UCSBRoboticsClub/viacar-2014/Solidworks/VC01.SLDPRT

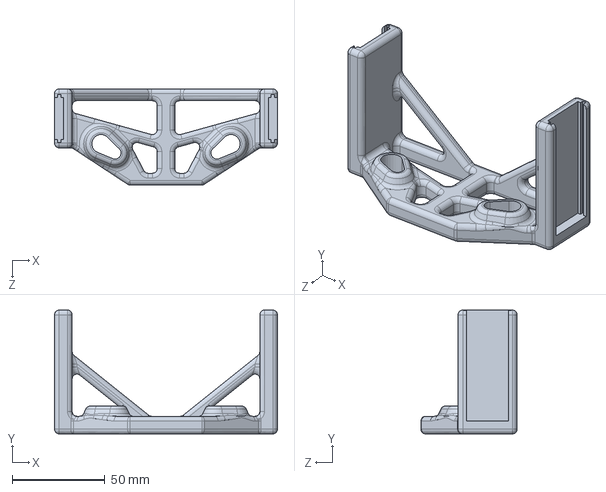
[picture p1: CAD file, 2014-02-02]
Solidworks/VC01.SLDPRT
120.0 x 66.7 x 51.8 mm
