UCSBRoboticsClub/viacar-2014/Solidworks/VC02.SLDPRT

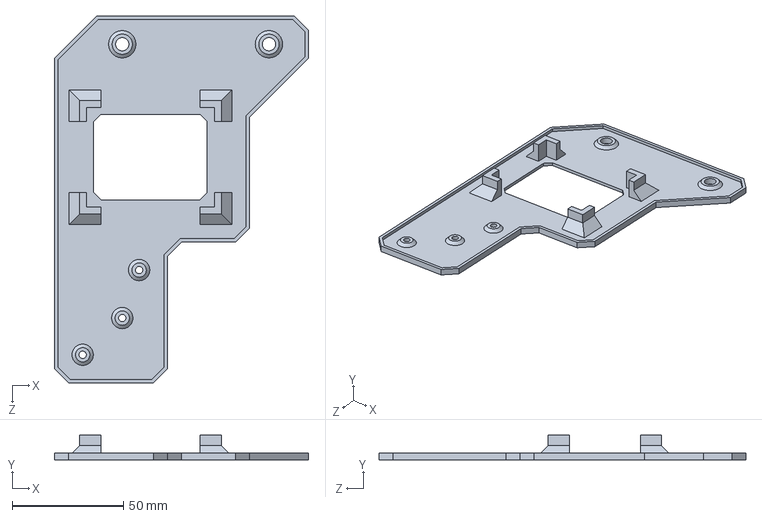
[picture p2: CAD file, 2014-01-17]
Solidworks/VC02.SLDPRT
114.3 x 11.1 x 165.1 mm
