UCSBRoboticsClub/viacar-2014/(list of files, cad)

Other CAD files:
Solidworks/VC01.STL
Solidworks/VC02.SLDDRW
