UCSBRoboticsClub/viacar-2014/Board files/sensor.brd

## EAGLE design Board files/sensor.brd (2014-03-01)

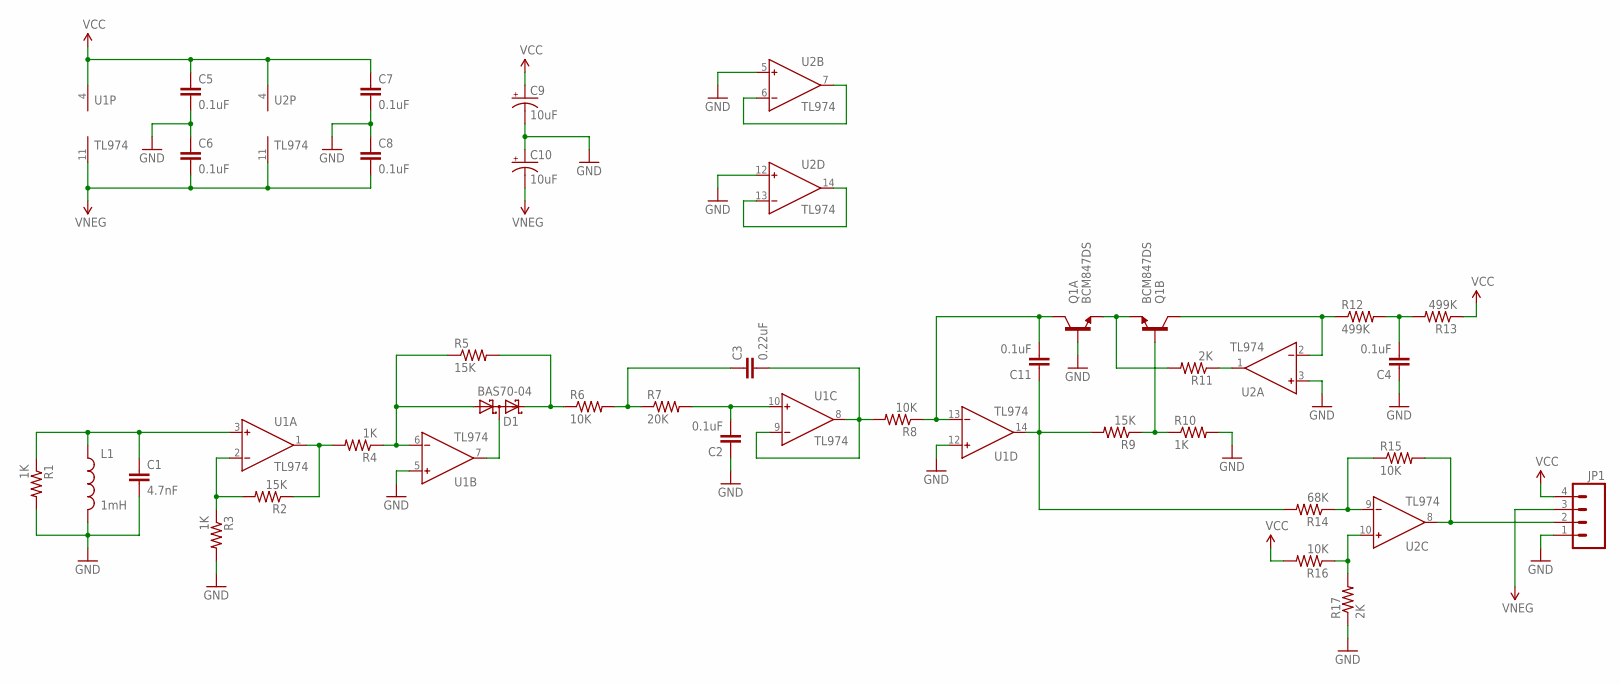
[picture p3: schematic sensor.sch]

Parts:
C1: 4.7nF; 0805
C2, C4, C5, C6, C7, C8, C11: 0.1uF; 0805
C3: 0.22uF; 0805
C9, C10: 10uF; E2-4
D1: BAS70-04; SOT23
JP1: M04POLAR_LOCK; MOLEX-1X4_LOCK
L1: 1mH; RLB0912
Q1: BCM847DS; SOT-457
R1, R3, R4, R10: 1K; 0805
R2, R5, R9: 15K; 0805
R6, R8, R15, R16: 10K; 0805
R7: 20K; 0805
R11, R17: 2K; 0805
R12, R13: 499K; 0805
R14: 68K; 0805
U1, U2: TL974; SOIC-14

Connections:
GND: C1.2, C2.1, C4.1, C5.2, C6.1, C7.2, C8.1, C9.-, C10.+, JP1.1, L1.2, Q1.2 (B), R1.2, R3.2, R10.2, R17.1, U1.5 (IN+), U1.12 (IN+), U2.3 (IN+), U2.5 (IN+), U2.12 (IN+)
unnamed: C1.1, L1.1, R1.1, U1.3 (IN+)
unnamed: D1.1 (A1), R4.1, R5.1, U1.6 (IN-)
unnamed: R2.2, R3.1, U1.2 (IN-)
unnamed: R2.1, R4.2, U1.1 (OUT)
unnamed: D1.2 (C2), R5.2, R6.1
unnamed: C2.2, R7.2, U1.10 (IN+)
unnamed: C3.1, R6.2, R7.1
unnamed: D1.3 (C1A2), U1.7 (OUT)
unnamed: U2.6 (IN-), U2.7 (OUT)
unnamed: C3.2, R8.2, U1.8 (OUT), U1.9 (IN-)
unnamed: U2.13 (IN-), U2.14 (OUT)
unnamed: C11.2, Q1.6 (C), R8.1, U1.13 (IN-)
unnamed: R11.1, U2.1 (OUT)
unnamed: Q1.1 (E), Q1.4 (E), R11.2
unnamed: Q1.5 (B), R9.1, R10.1
unnamed: C11.1, R9.2, R14.2, U1.14 (OUT)
unnamed: C4.2, R12.2, R13.2
unnamed: Q1.3 (C), R12.1, U2.2 (IN-)
unnamed: R16.1, R17.2, U2.10 (IN+)
unnamed: R14.1, R15.1, U2.9 (IN-)
unnamed: JP1.2, R15.2, U2.8 (OUT)
VCC: C5.1, C7.1, C9.+, JP1.4, R13.1, R16.2, U1.4 (V+), U2.4 (V+)
VNEG: C6.2, C8.2, C10.-, JP1.3, U1.11 (V-), U2.11 (V-)

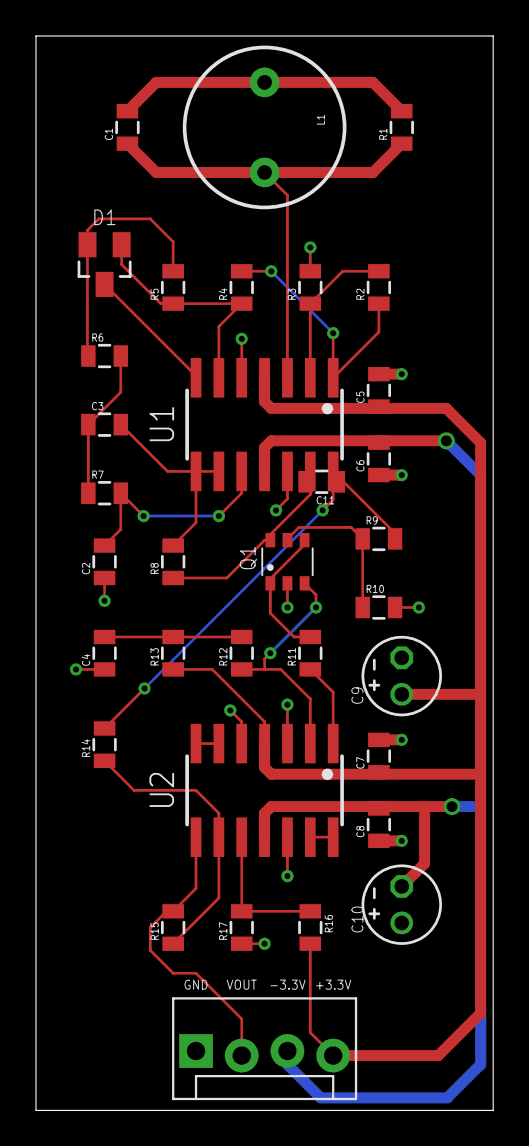
[picture p4: board sensor.brd from above]

Board: 2 copper layers, 25.4 x 59.7 mm, 34 parts (0 on the bottom side), 24 nets.
