UCSBRoboticsClub/viacar-2014/Board files/logic.brd

## EAGLE design Board files/logic.brd (2014-01-12)

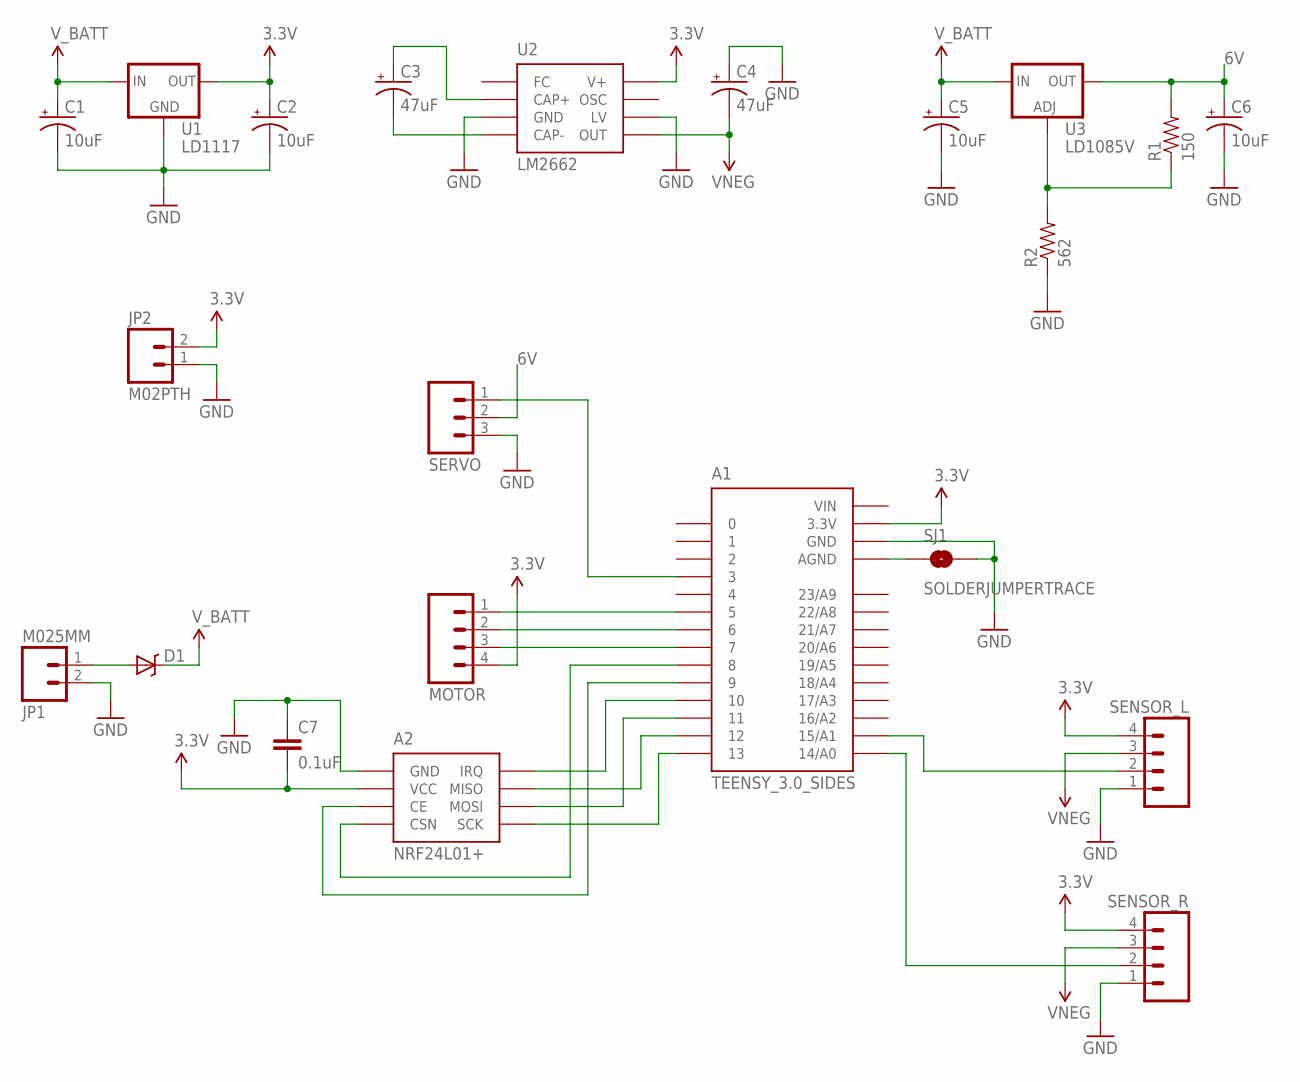
[picture p5: schematic logic.sch]

Parts:
A1: TEENSY_3.0_SIDES
A2: NRF24L01+
C1, C2, C5, C6: 10uF; E2-4
C3, C4: 47uF; CPOL-RADIAL-100UF-25V
C7: 0.1uF; 0805
D1: DIODE-SCHOTTKY_; SMA-DIODE
JP1: M025MM; SCREWTERMINAL-5MM-2
JP2: M02PTH; 1X02
MOTOR: M04POLAR_LOCK; MOLEX-1X4_LOCK
R1: 150; 0805
R2: 562; 0805
SENSOR_L: M04POLAR_LOCK; MOLEX-1X4_LOCK
SENSOR_R: M04POLAR_LOCK; MOLEX-1X4_LOCK
SERVO: M03LOCK_LONGPADS; 1X03_LOCK_LONGPADS
SJ1: SOLDERJUMPERTRACE; SJ_2S-TRACE
U1: LD1117; SOT-223
U2: LM2662; SOIC-8
U3: LD1085V; 317TS

Connections:
3.3V: A1.3.3V, A2.2 (VCC), C2.+, C7.2, JP2.2, MOTOR.4, SENSOR_L.4, SENSOR_R.4, U1.2 (OUT), U1.4 (OUT), U2.8 (V+)
6V: C6.+, R1.2, SERVO.2, U3.2 (OUT)
GND: A1.GND, A2.1 (GND), C1.-, C2.-, C4.1 (+), C5.-, C6.-, C7.1, JP1.2, JP2.1, R2.1, SENSOR_L.1, SENSOR_R.1, SERVO.3, SJ1.2, U1.1 (GND), U2.3 (GND), U2.6 (LV)
unnamed: D1.A, JP1.1
unnamed: C3.1 (+), U2.2 (CAP+)
unnamed: C3.2 (-), U2.4 (CAP-)
unnamed: R1.1, R2.2, U3.1 (ADJ)
unnamed: A1.13, A2.5 (SCK)
unnamed: A1.12, A2.7 (MISO)
unnamed: A1.11, A2.6 (MOSI)
unnamed: A1.8, A2.4 (CSN)
unnamed: A1.10, A2.8 (IRQ)
unnamed: A1.9, A2.3 (CE)
unnamed: A1.3, SERVO.1
unnamed: A1.AGND, SJ1.1
unnamed: A1.15/A1, SENSOR_L.2
unnamed: A1.14/A0, SENSOR_R.2
unnamed: A1.5, MOTOR.1
unnamed: A1.6, MOTOR.2
unnamed: A1.7, MOTOR.3
VIN: A1.VIN
VNEG: C4.2 (-), SENSOR_L.3, SENSOR_R.3, U2.5 (OUT)
V_BATT: C1.+, C5.+, D1.C, U1.3 (IN), U3.3 (IN)

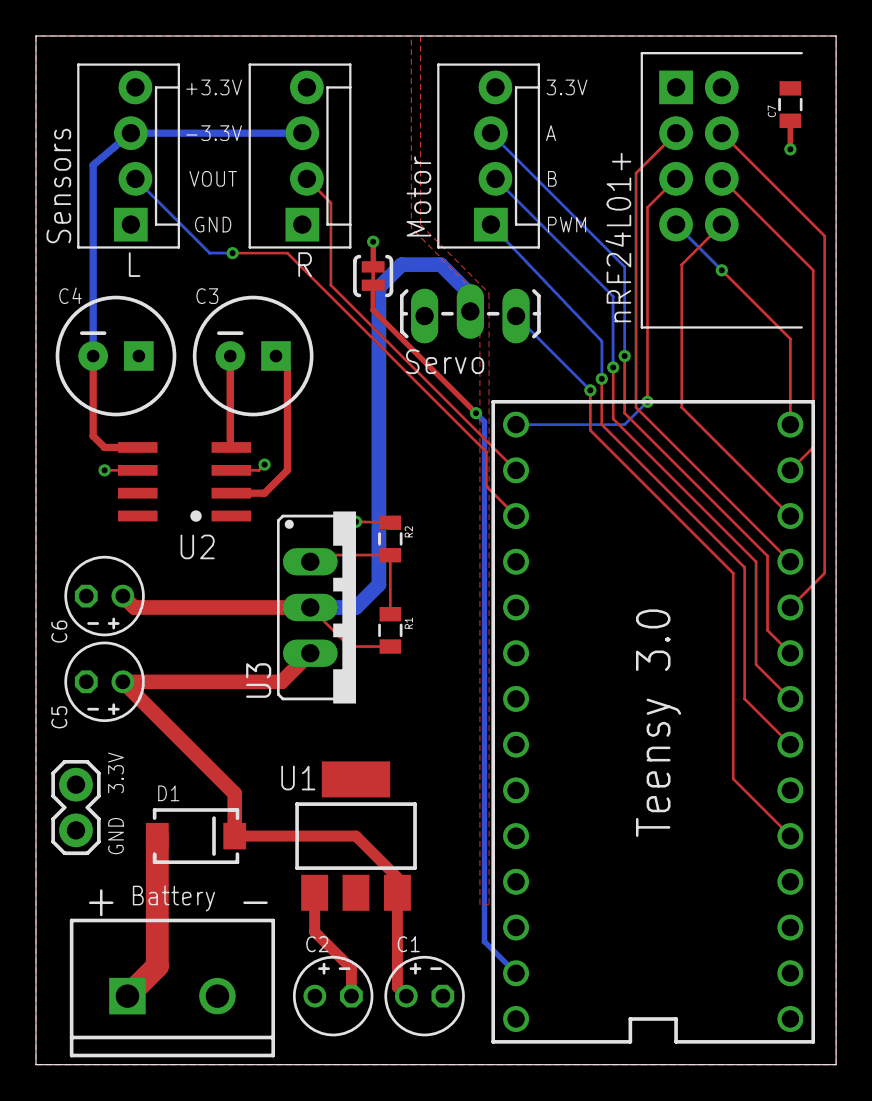
[picture p6: board logic.brd from above]

Board: 2 copper layers, 44.5 x 57.1 mm, 22 parts (0 on the bottom side), 22 nets.
