UCSBRoboticsClub/viacar-2014/Board files/motordriver.brd

## EAGLE design Board files/motordriver.brd (2014-01-12)

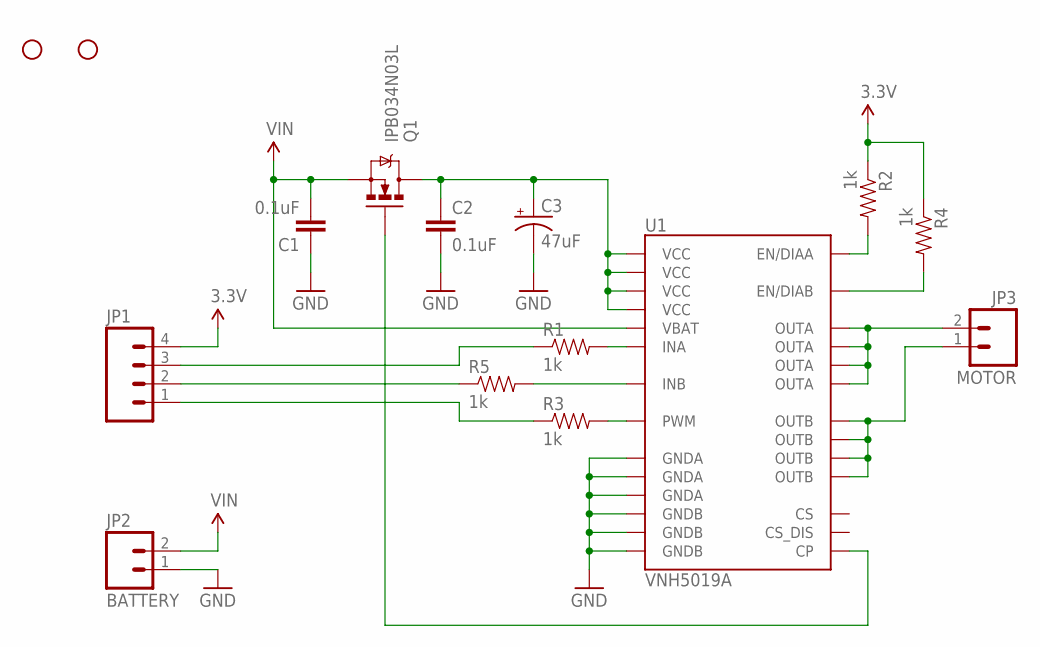
[picture p7: schematic motordriver.sch]

Parts:
C1, C2: 0.1uF; 0805
C3: 47uF; CPOL-RADIAL-100UF-25V
JP1: M04POLAR_LOCK; MOLEX-1X4_LOCK
JP2: BATTERY; SCREWTERMINAL-5MM-2
JP3: MOTOR; SCREWTERMINAL-5MM-2
Q1: IPB034N03L; DPAK
R1, R2, R3, R4, R5: 1k; 0805
STANDOFF1, STANDOFF2: STAND-OFF
U1: VNH5019A; MULTIPOWERSO-30

Connections:
3.3V: JP1.4, R2.1, R4.1
GND: C1.1, C2.2, C3.2 (-), JP2.1, U1.18 (GNDB), U1.19 (GNDB), U1.20 (GNDB), U1.26 (GNDA), U1.27 (GNDA), U1.28 (GNDA)
unnamed: R1.2, U1.4 (INA)
unnamed: R5.2, U1.10 (INB)
unnamed: R3.2, U1.7 (PWM)
unnamed: Q1.1 (G), U1.11 (CP)
unnamed: JP1.2, R5.1
unnamed: JP1.3, R1.1
unnamed: JP1.1, R3.1
unnamed: R2.2, U1.5 (EN/DIAA)
unnamed: R4.2, U1.9 (EN/DIAB)
OUTA: JP3.2, U1.1 (OUTA), U1.25 (OUTA), U1.30 (OUTA), U1.SLUG3 (OUTA)
OUTB: JP3.1, U1.15 (OUTB), U1.16 (OUTB), U1.21 (OUTB), U1.SLUG2 (OUTB)
VCC: C2.1, C3.1 (+), Q1.4 (D), U1.3 (VCC), U1.13 (VCC), U1.23 (VCC), U1.SLUG1 (VCC)
VIN: C1.2, JP2.2, Q1.3 (S), U1.12 (VBAT)

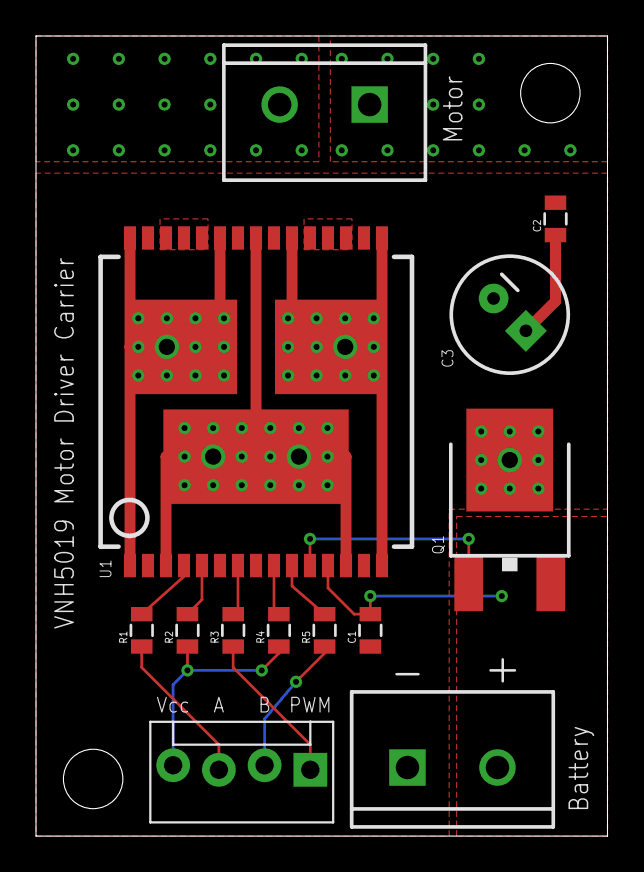
[picture p8: board motordriver.brd from above]

Board: 2 copper layers, 31.8 x 44.5 mm, 15 parts (0 on the bottom side), 15 nets.
