UCSBRoboticsClub/viacar-2014/Viacar2014/ControlLoop.h

#ifndef CONTROLLOOP_H
#define CONTROLLOOP_H

#include "LowPass.h"


class ControlLoop
{
public:
    ControlLoop(float dt);
    float update(float error, float feedForward = 0.f);
    void setTuning(float kp, float ki, float kd);
    void setKp(float kp);
    void setKi(float ki);
    void setKd(float kd);
    float setDerivCutoffFreq(float freq);
    void setOutputLimits(float min, float max);
    
private:
    float ierror;
    LowPass derror;
    const float dt;
    float kp;
    float ki;
    float kd;
    float outputMin;
    float outputMax;
    float lastError;
};

#endif // CONTROLLOOP_H
