UCSBRoboticsClub/viacar-2014/Viacar2014/Button.h

#ifndef BUTTON_H
#define BUTTON_H


class Button
{
public:
    Button(int pin, bool activeState = true, bool pullup = false);
    bool setPullup(bool on);
    void update();
    bool pressed();
    bool pressEdge();
    bool releaseEdge();
    
private:
    int pin;
    bool activeState;
    bool state;
    bool edge;
};

#endif // BUTTON_H
