UCSBRoboticsClub/viacar-2014/(commit log)

2013-12-21 Motor driver board is complete
    [motordriver.brd, motordriver.sch]
2013-12-22 Added sensor board
    [sensor.brd, sensor.sch]
2013-12-27 Modified motor driver layout
    [motordriver.brd, motordriver.sch, sensor.brd, sensor.sch]
2013-12-27 Added battery polarity labels
    Also cleaned up layout slightly
    [motordriver.brd]
2013-12-27 Fixed slightly misaligned board outline
    [motordriver.brd]
2013-12-27 Added labels and removed some thermals
    [motordriver.brd, motordriver.sch]
2013-12-27 Made silkscreen orientation consistent
    [motordriver.brd]
2013-12-29 Significantly modified sensor circuit
    [sensor.brd, sensor.sch]
2013-12-29 Finished new sensor board layout
    [sensor.brd, sensor.sch]
2013-12-29 Tweaked ground pour
    [sensor.brd]
2013-12-29 Cleaned up wires on motor driver board
    [motordriver.brd]
2013-12-30 Added component values and removed final rectifier
    [sensor.brd, sensor.sch]
2013-12-31 Added logic board, schematic is complete
    [logic.brd, logic.sch]
2013-12-31 Finished logic board layout
    [logic.brd, logic.sch]
2013-12-31 Rerouted servo trace and added labels
    [logic.brd]
2013-12-31 Fixed decoupling caps and added labels
    [sensor.brd, sensor.sch]
2013-12-31 Added larger decoupling capacitors to the sensor boards
    [sensor.brd, sensor.sch]
2013-12-31 Increased initial sensor gain from 8 to 256
    [sensor.brd, sensor.sch]
2014-01-01 Changed logic board layout
    [logic.brd, logic.sch, sensor.brd]
2014-01-01 More logic board edits
    [logic.brd]
2014-01-01 Labels are no longer obscured by vias
    [logic.brd]
2014-01-06 Minor logic board changes
    [logic.brd, logic.sch]
2014-01-11 Switched to polarized connectors
    Also added 3.3v out pins on logic board, various other changes
    [logic.brd, logic.sch, motordriver.brd, motordriver.sch, sensor.brd, sensor.sch]
2014-01-12 Modified boards to facilitate mounting
    [motordriver.brd, motordriver.sch, sensor.brd]
2014-01-12 Added CAD models for board mounts
    [VC01.SLDPRT, VC02.SLDPRT]
2014-01-12 Fixed silkscreen positioning
    [motordriver.brd]
2014-01-12 Moved some components
    [motordriver.brd]
2014-01-12 Moved a capacitor
    [motordriver.brd]
2014-01-12 Modified a trace, sending the boards out to manufacture
    [logic.brd]
2014-01-17 Updated solidworks models, added mouting plate drawing
    [VC01.SLDPRT, VC02.SLDDRW, VC02.SLDPRT]
2014-01-28 Slight tweak
    [VC01.SLDPRT]
2014-02-02 Reduced weight, added better support
    [VC01.SLDPRT, VC01.STL]
2014-02-08 Fixed sensor board bug
    Added a capacitor between U1p13 and U1p14
    [sensor.brd, sensor.sch]
2014-02-22 Added teensy code
2014-02-23 Made low pass filter class, added load measurement
2014-02-23 Updated the voltage to distance calibration function
2014-02-24 Modified calibration function
    Add automatic detection of vinmax next
2014-03-01 Fixed level shifter resistor values
    [sensor.brd, sensor.sch]
2014-04-12 Sensor actually works now
2014-04-12 Added calibration code
    Changed lowpass interface
2014-04-13 Changed button interface
2014-04-19 Fixed ControlLoop and error function
    [ControlLoop.cpp, Viacar2014.ino]
2014-05-04 Added program for calibrating servo
